SegwayWarrior/Cobot_Control_on_Touchscreen/images/cycloid_cad.png

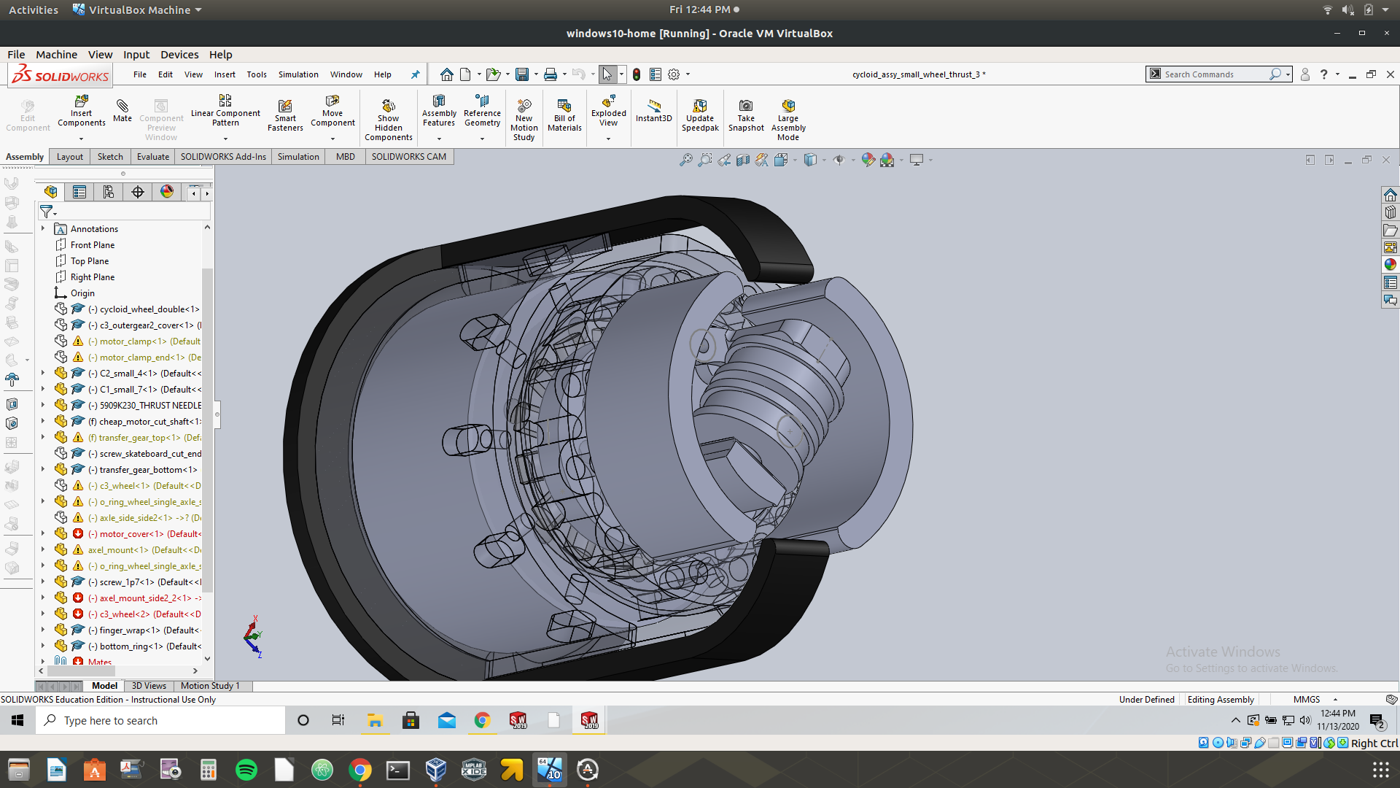
images/cycloid_cad.png
