SegwayWarrior/Cobot_Control_on_Touchscreen/images/main_pic.jpg

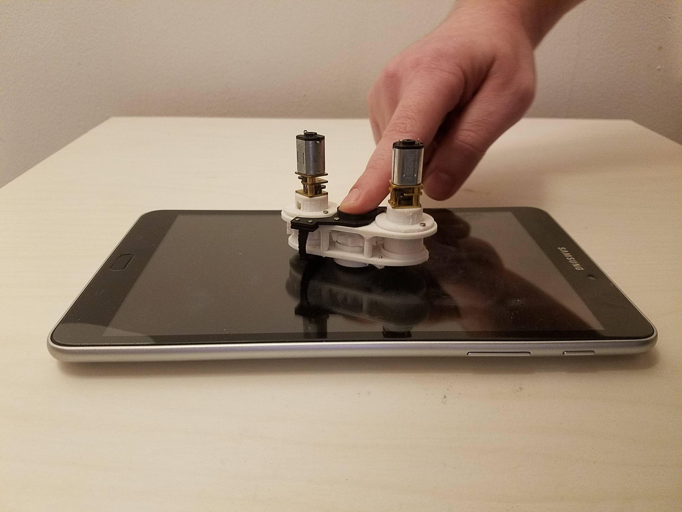
images/main_pic.jpg
